ZoranBi/Project-LOOM/README.md

# Project-LOOM

This repository contains the artifacts of the flowmeter module, including the PCB design, enclosure design, and some documentation.
