ZoranBi/Project-LOOM/Documentation/README.txt

# Project-LOOM-Documentation

This repository contains related documentation, including the validation paper, material budget, and the power budget.
