ZoranBi/Project-LOOM/Enclosure/README.txt

# Project-LOOM-Enclosure

This repository contains the enclosure design. The tools used is SolidWorks. This folder has two different version of the enclosure. One has room for battery; The other one has no battery.
