ZoranBi/Project-LOOM/PCB/README.txt

# Project-LOOM-PCB

This repository contains the PCB design. The software used is Altium Designer.
