ZoranBi/Project-LOOM/Enclosure/enclosure_without_battery.png

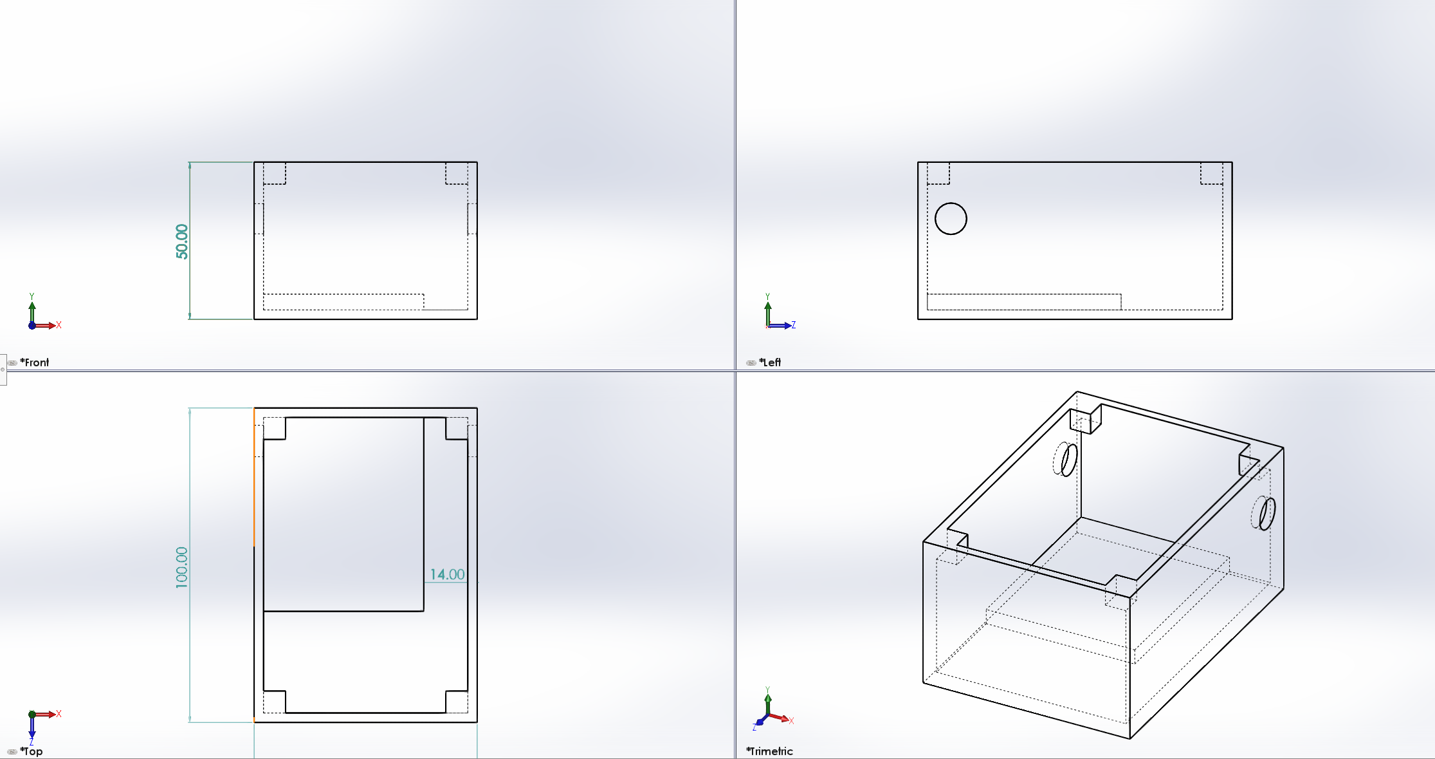
Enclosure/enclosure_without_battery.png
