ZoranBi/Project-LOOM/Documentation/LOOM_Bill of Materials.xlsx

Bill of Materials
 | Component | Category | Parameter | Datasheet | Source | Unit Price | Number | Total
1 | Adafruit: WiFi Development Tools (802.11) Adafruit Feather M0 WiFi - ATSAMD21 + ATWINC1500 | MCU |  | https://www.mouser.com/datasheet/2/737/adafruit-feather-m0-wifi-atwinc1500-879974.pdf | Mouser | $34.95 | 1 | $34.95
2 | IDT: Flowmeter FS1012-1001-LQ | Sensor |  | https://www.mouser.com/datasheet/2/464/IDT_FS1012-Datasheet_DST_20181119-1143610.pdf | Mouser | $37.08 | 1 | $37.08
3 | Switchcraft: RAPC712S | DC Power Jack |  | https://www.mouser.com/datasheet/2/393/RAPC712S_CD-1391753.pdf | Mouser | $2.59 | 1 | $2.59
4 | TI: LMC6032IN/NOPB | Op Amp |  | http://www.ti.com/general/docs/suppproductinfo.tsp?distId=26 | Mouser | $1.15 | 1 | $1.15
5 | TI: LM2575SX-5.0/NOPB | Switching Voltage Regulators |  | http://www.ti.com/general/docs/suppproductinfo.tsp?distId=26 | Mouser | $2.95 | 1 | $2.95
6 | Coilcraft: MSS1278T-334KLD | Fixed Inductors | 330 uH 10 % 1 A | https://www.mouser.com/datasheet/2/597/mss1278t-270649.pdf | Mouser | $2.66 | 1 | $2.66
7 | Panasonic: EEH-ZC1E101XV | Capacitors | 25VDC 100uF | https://www.mouser.com/datasheet/2/315/ABA0000C1234-1218024.pdf | Mouser | $1.89 | 1 | $1.89
8 | Panasonic: EEH-ZK1V331P | Capacitors | 35v 330uF | https://www.mouser.com/datasheet/2/315/ABA0000C1229-1316762.pdf | Mouser | $2.36 | 1 | $2.36
9 | Murata Electronics: GCM21BL8EG475KE08L | Capacitors | 4.7uF | https://www.mouser.com/datasheet/2/281/murata_03122018_GCM_Series-1310150.pdf | Mouser | $0.68 | 1 | $0.68
10 | STMicroelectronics: 1N5817 | Schottky Diodes | Vr/20V Io/1A BULK | https://www.mouser.com/datasheet/2/389/1n5817-954386.pdf | Mouser | $0.39 | 1 | $0.39
11 |  | Resistor | 10K |  | Mouser | $0.20 | 2 | $0.40
12 |  | Resistor | 2K |  | Mouser | $0.20 | 1 | $0.20
13 |  | Resistor | 1K |  | Mouser | $0.20 | 1 | $0.20
14 |  | Resistor | 200 |  | Mouser | $0.20 | 1 | $0.20
15 | PCB print | PCB |  |  |  | $7.80 | 5 | $39.00
 |  |  |  |  |  |  | Total: | $126.70
