ZoranBi/Project-LOOM/Enclosure/Assem1.SLDASM

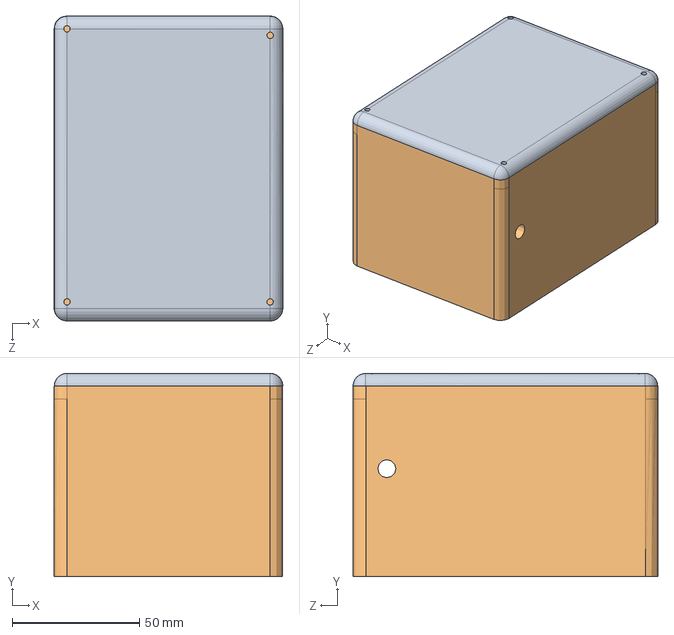
[picture p3: CAD file, 2019-02-23]
Enclosure/Assem1.SLDASM
90.1 x 80.0 x 120.1 mm
cover
enclosure
