ZoranBi/Project-LOOM/Enclosure/Enclosure_FinalVer/Enclosure_FinalVer_Assem1.SLDASM

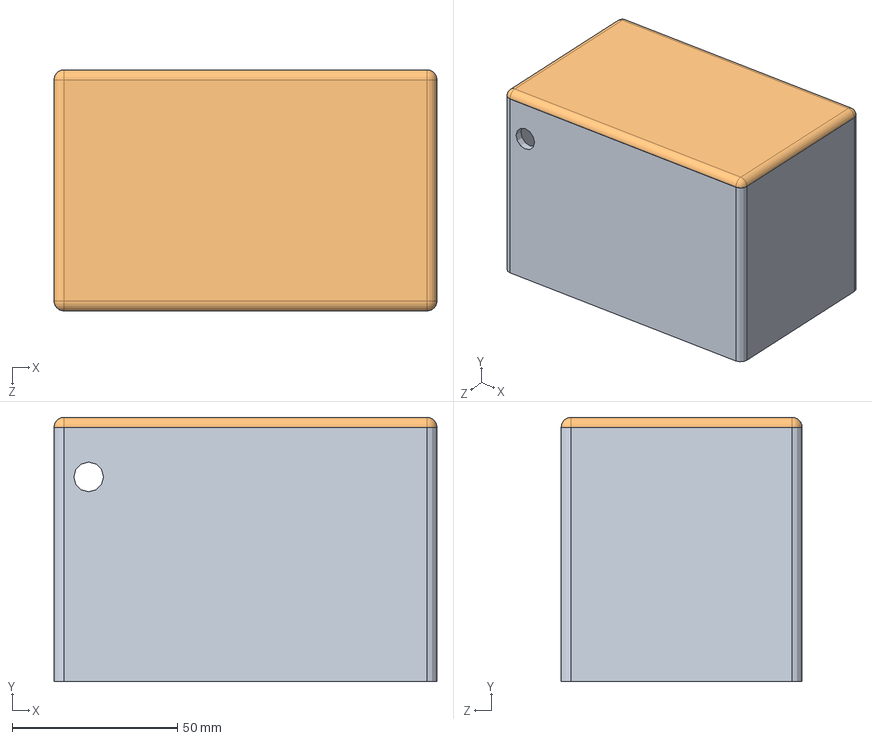
[picture p4: CAD file, 2019-05-17]
Enclosure/Enclosure_FinalVer/Enclosure_FinalVer_Assem1.SLDASM
116.0 x 80.0 x 73.1 mm
enclosure_final_version
enclosure_final_version_cover
enclosure_final_version_plat
