ZoranBi/Project-LOOM/Enclosure/Enclosure_FinalVer/enclosure_stl/enclosure_final_version_plat.STL

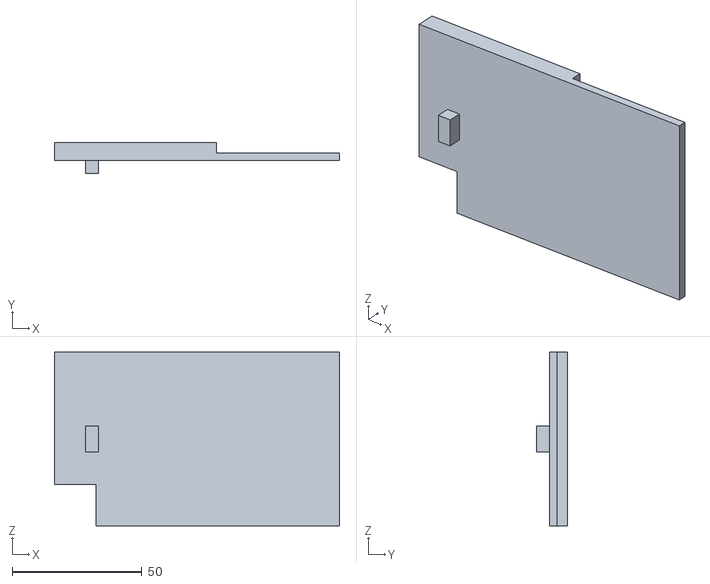
[picture p5: CAD file, 2019-05-17]
Enclosure/Enclosure_FinalVer/enclosure_stl/enclosure_final_version_plat.STL
110.0 x 12.0 x 67.0
