ZoranBi/Project-LOOM/Enclosure/Enclosure_FinalVer/enclosure_without_battery.SLDPRT

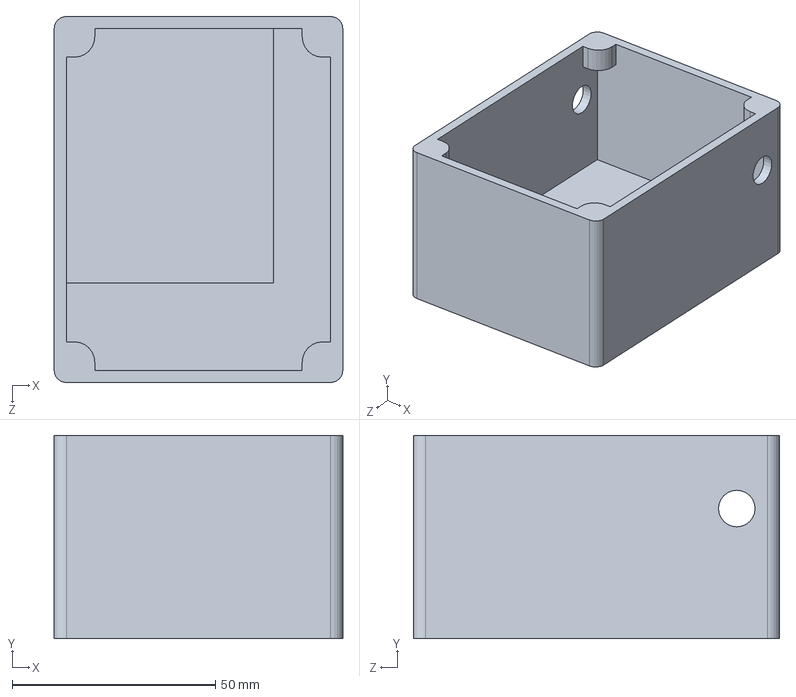
[picture p6: CAD file, 2019-05-17]
Enclosure/Enclosure_FinalVer/enclosure_without_battery.SLDPRT
71.0 x 50.0 x 90.0 mm
