ZoranBi/Project-LOOM/Enclosure/cover_without_battery.SLDPRT

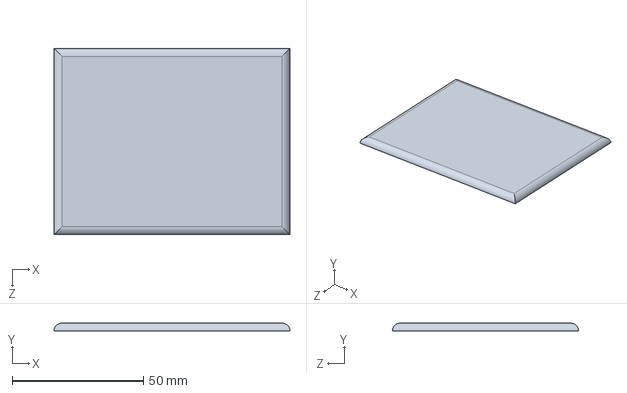
[picture p7: CAD file, 2019-05-17]
Enclosure/cover_without_battery.SLDPRT
90.0 x 3.00 x 71.0 mm
