ZoranBi/Project-LOOM/Enclosure/Enclosure_FinalVer/enclosure_stl/enclosure_final_version.STL

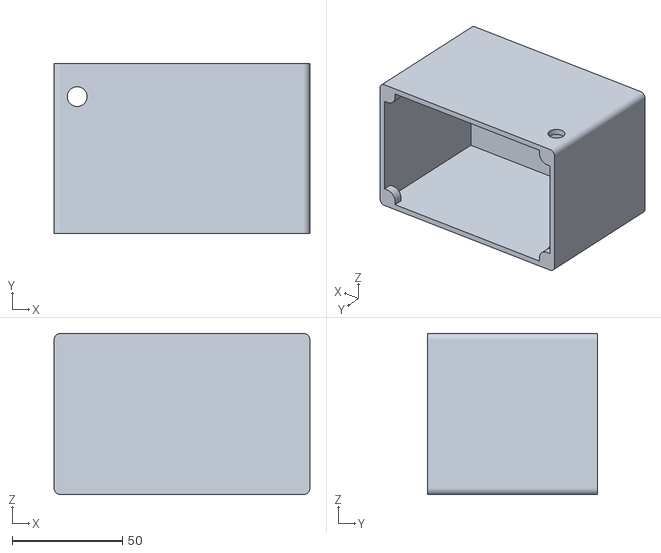
[picture p8: CAD file, 2019-05-17]
Enclosure/Enclosure_FinalVer/enclosure_stl/enclosure_final_version.STL
116.0 x 77.0 x 73.0
