ZoranBi/Project-LOOM/Enclosure/enclosure.SLDPRT

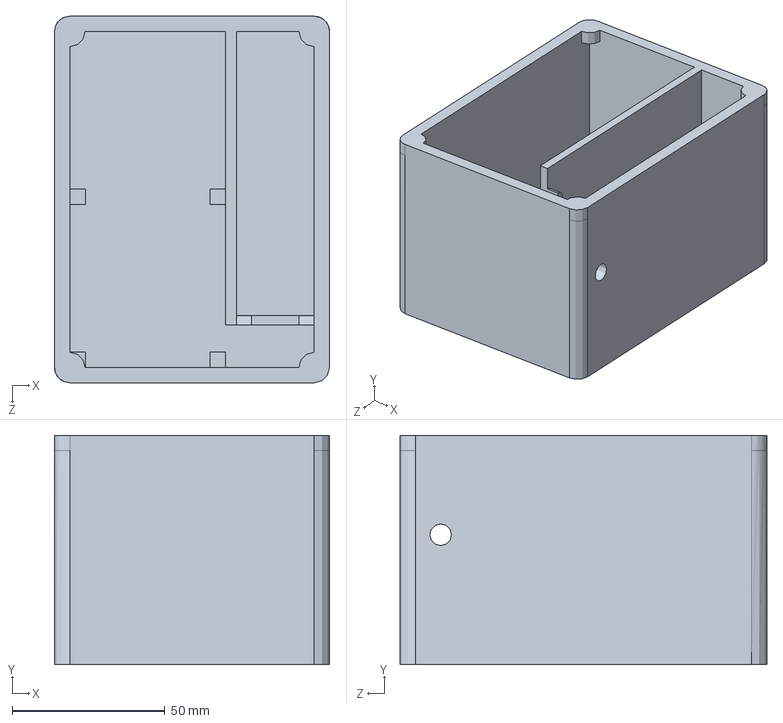
[picture p9: CAD file, 2019-04-30]
Enclosure/enclosure.SLDPRT
90.0 x 75.0 x 120.0 mm
