ZoranBi/Project-LOOM/Enclosure/Enclosure_FinalVer/enclosure_final_version_cover.SLDPRT

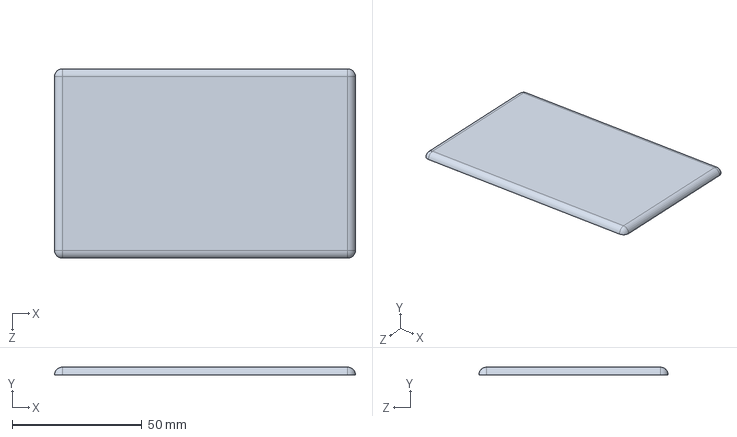
[picture p10: CAD file, 2019-05-17]
Enclosure/Enclosure_FinalVer/enclosure_final_version_cover.SLDPRT
116.0 x 3.00 x 73.0 mm
