ZoranBi/Project-LOOM/Enclosure/cover.SLDPRT

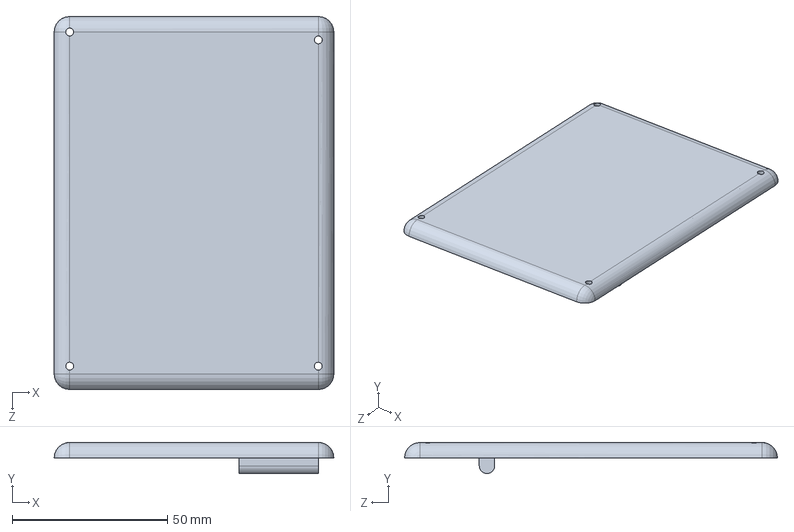
[picture p11: CAD file, 2019-02-23]
Enclosure/cover.SLDPRT
90.0 x 10.0 x 120.0 mm
