ZoranBi/Project-LOOM/(list of files, cad)

Other CAD files:
Enclosure/Enclosure_FinalVer/no_battery_stl/enclosure_without_battery.STL
Enclosure/Enclosure_FinalVer/no_battery_stl/cover_without_battery.STL
Enclosure/Enclosure_FinalVer/enclosure_stl/enclosure_final_version_cover.STL
Enclosure/Enclosure_FinalVer/enclosure_final_version.SLDPRT
Enclosure/Enclosure_FinalVer/enclosure_final_version_plat.SLDPRT
Enclosure/cover.STL
Enclosure/enclosure.STL
