ZoranBi/Project-LOOM/PCB/Project_LOOM.pdf

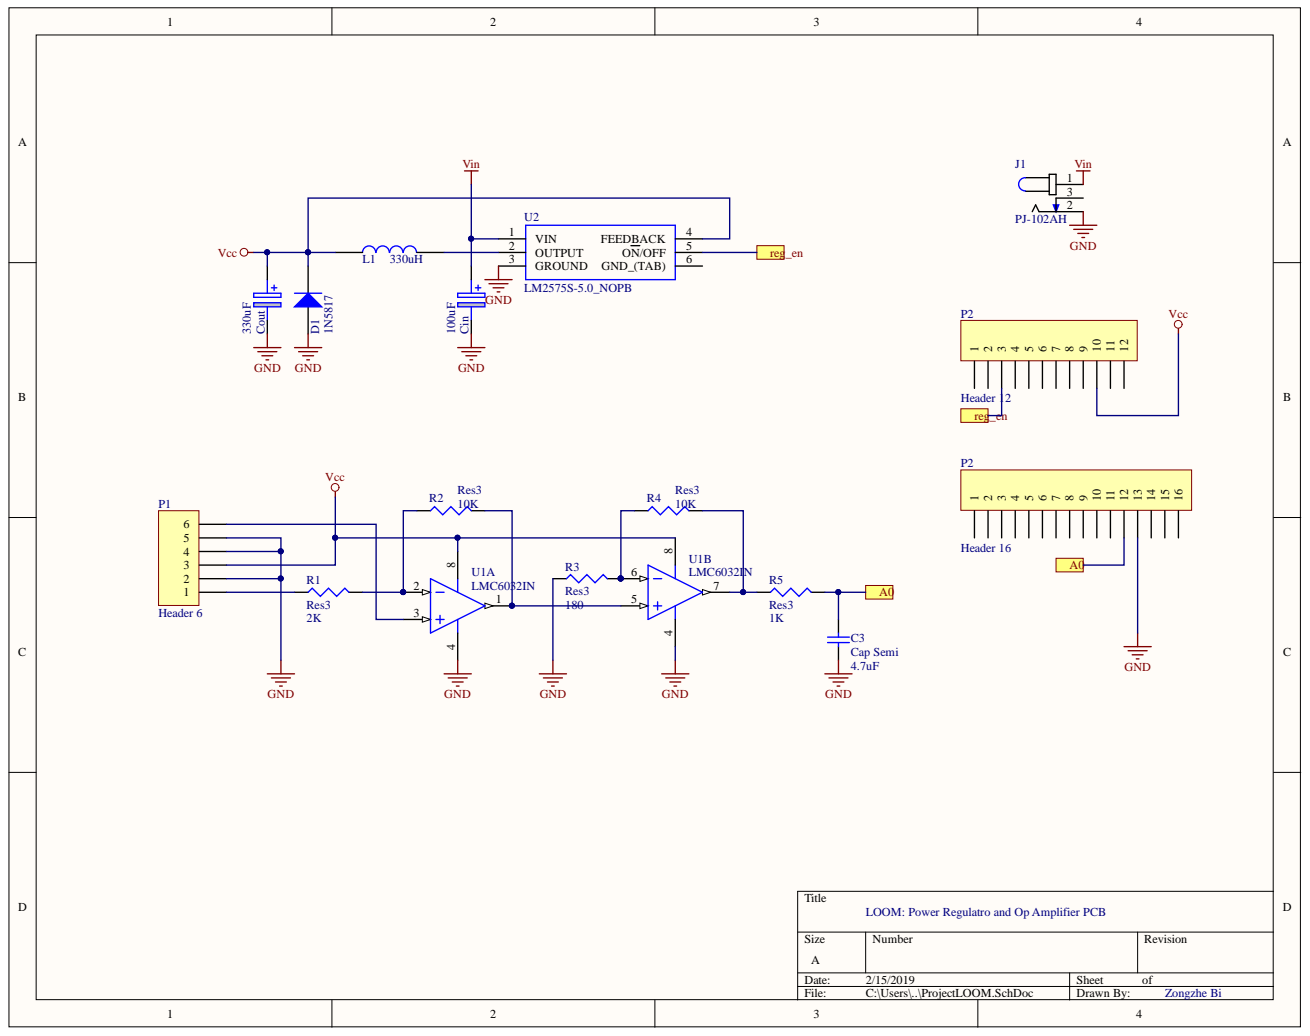
[picture p12: page 1]

LOOM: Power Regulatro and Op Amplifier PCB

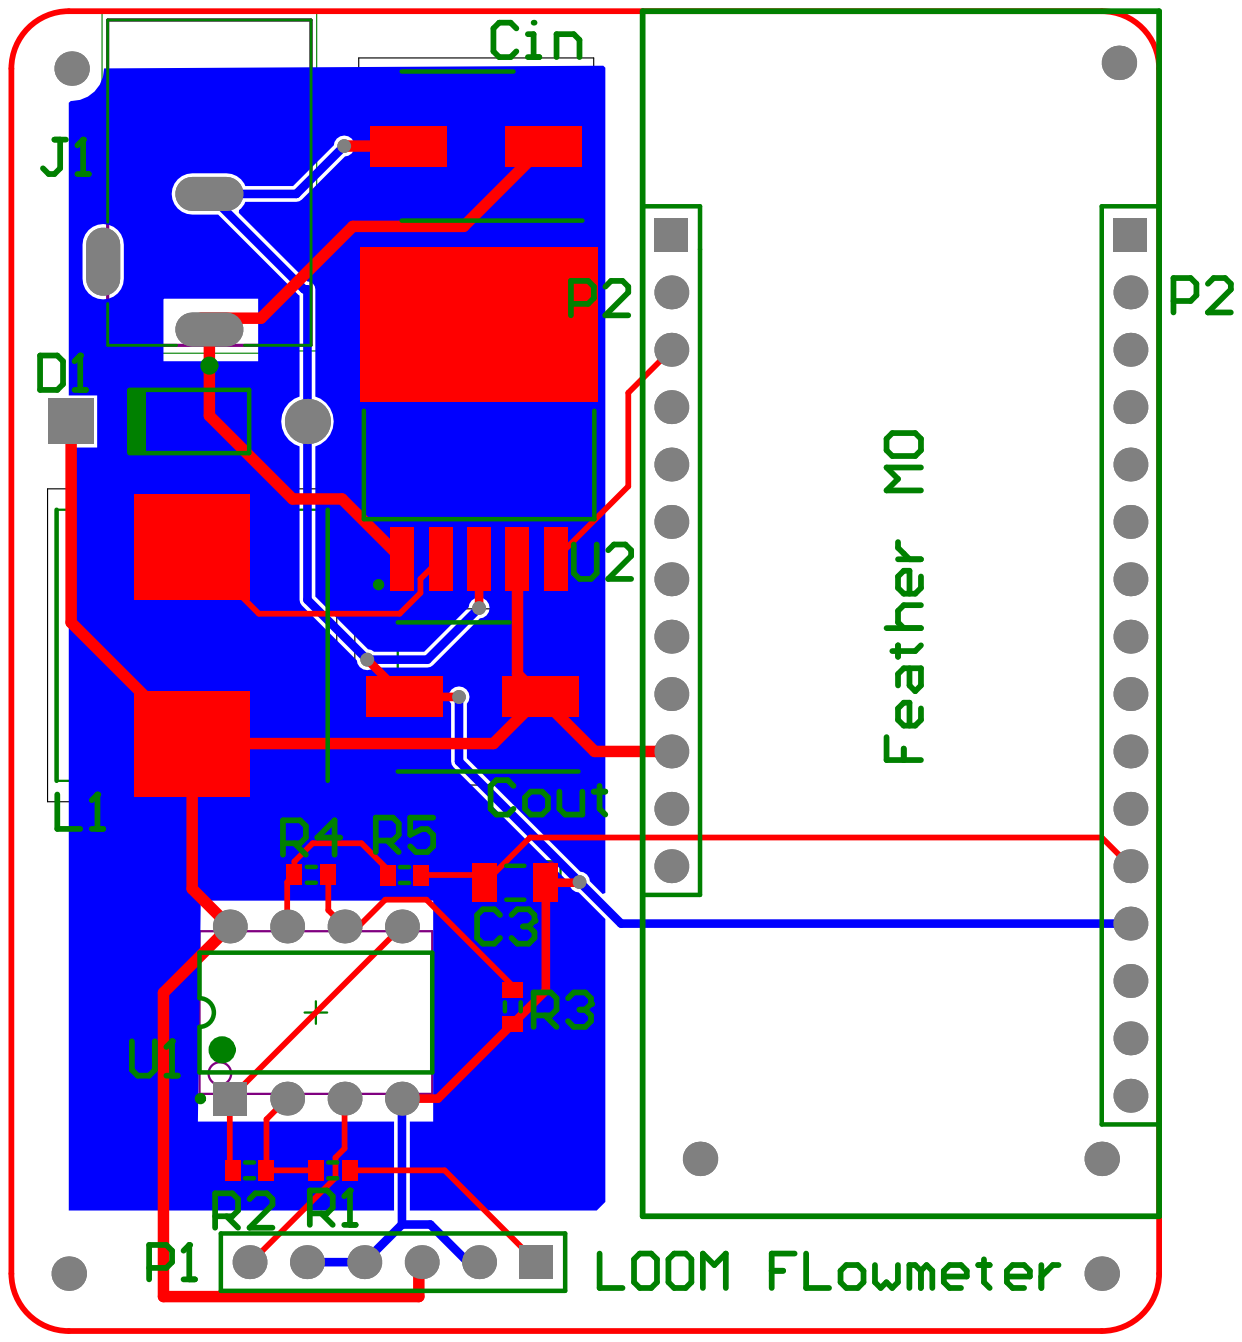
[picture p13: page 2]

# Board Stack
