ZoranBi/Project-LOOM/(list of files, drawings)

Other design files:
PCB/Project_LOOM.PrjPcb
PCB/ProjectLOOM.PcbDoc
PCB/ProjectLOOM_2.PrjPcb
