ZoranBi/Project-LOOM/(commit log)

2019-02-15 Ini
    Update previous work
    [ProjectLOOM.PcbDoc, ProjectLOOM.PcbLib, ProjectLOOM.PrjPcb, ProjectLOOM.SchDoc, ProjectLOOM.SchLib, ProjectLOOM_2.PrjPcb]
2019-02-15 initial update changed
    [ProjectLOOM.PcbDoc, ProjectLOOM.PcbLib, ProjectLOOM.PrjPcb, ProjectLOOM.SchDoc, ProjectLOOM.SchLib, ProjectLOOM_2.PrjPcb, Project_LOOM.PrjPcb]
2019-02-15 This is the bill of material for flowmeter design.
    [LOOM_Bill of Materials.xlsx]
2019-02-17 finished the enclosure and adjust the PCB
    [Assem1.SLDASM, cover.SLDPRT, enclosure.SLDPRT]
2019-04-30 Update new enclosure
    The enclosure has no room for battery to shrink the size.
    [cover_without_battery.SLDPRT, enclosure.SLDPRT, enclosure_without_battery.SLDPRT]
2019-05-17 Updates documentation
    Added some related documentation including datasheets and did some arrangement
    [Enclosure_FinalVer_Assem1.SLDASM, LOOM_Bill of Materials.xlsx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]
